dyrdahl/ac-mesh-controller/(commit log)

2026-02-13 Better description of capacitor modification
2026-02-16 Added images of 3D printed case of keypad node
